GadgetReboot/AY-3-8910/README.md

# AY-3-8910
AY-3-8910 Sound Generator PCB controlled by Arduino Nano<BR><BR>
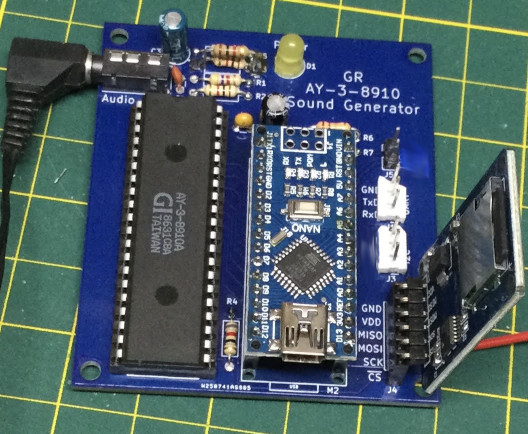
[picture p1: Assembled_PCB.jpg]
pcb
<br><br>
