GadgetReboot/AY-3-8910/AY-3-8910-sch.pdf

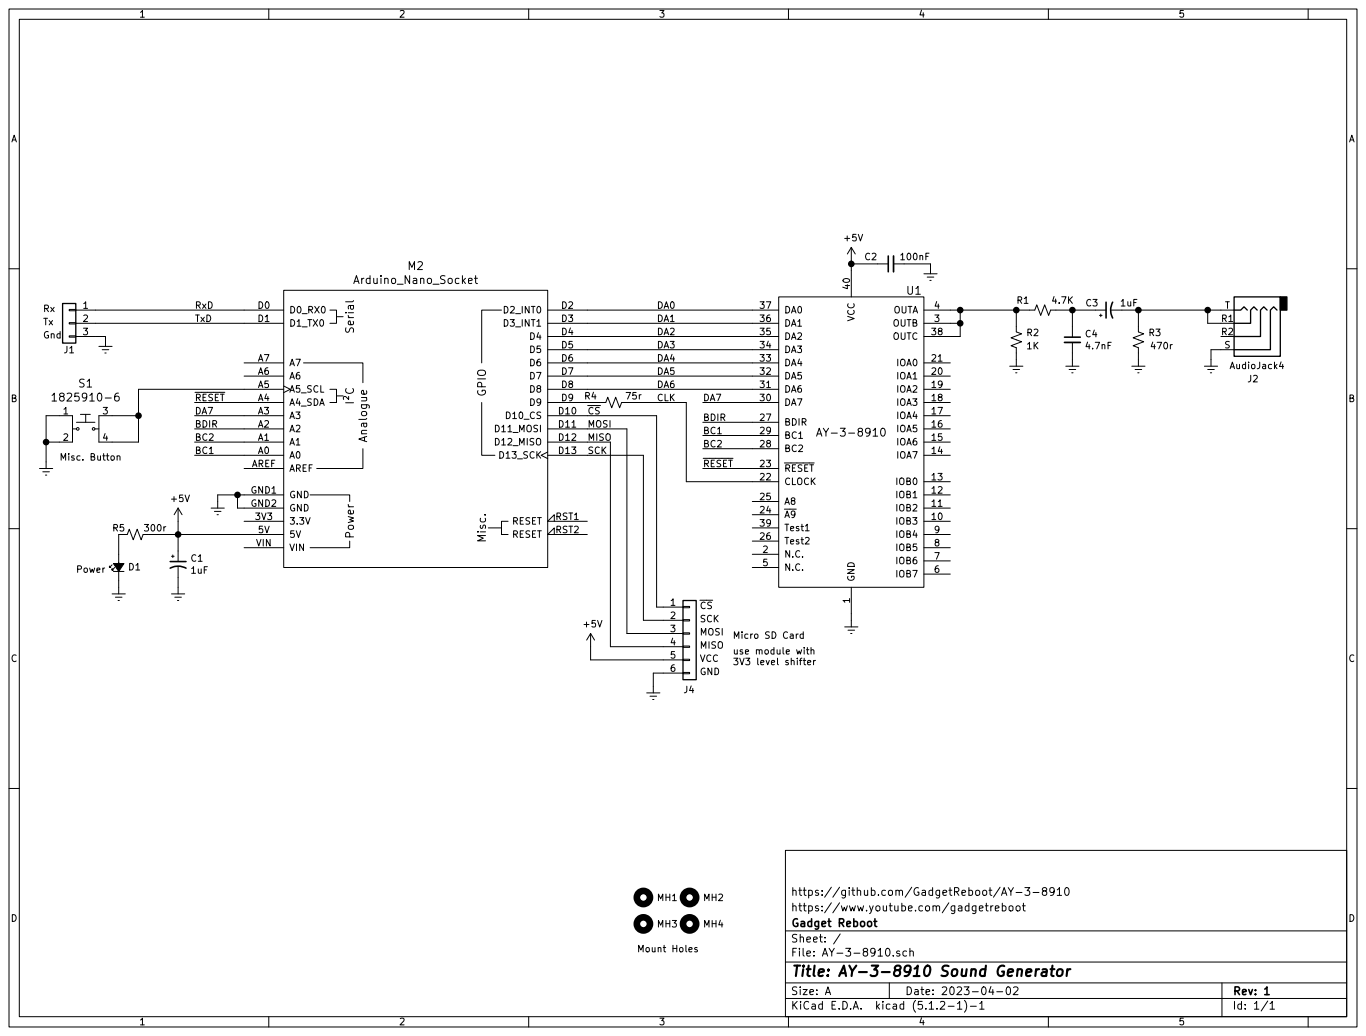
[picture p2: page 1]

https://www.youtube.com/gadgetreboot
Id: 1/1 Title: AY-3-8910 Sound Generator File: AY-3-8910.sch Sheet: / Gadget Reboot
