GadgetReboot/AY-3-8910/KiCad/AY-3-8910.kicad_pcb

## KiCad design KiCad/AY-3-8910.kicad_pcb (2023-04-19)

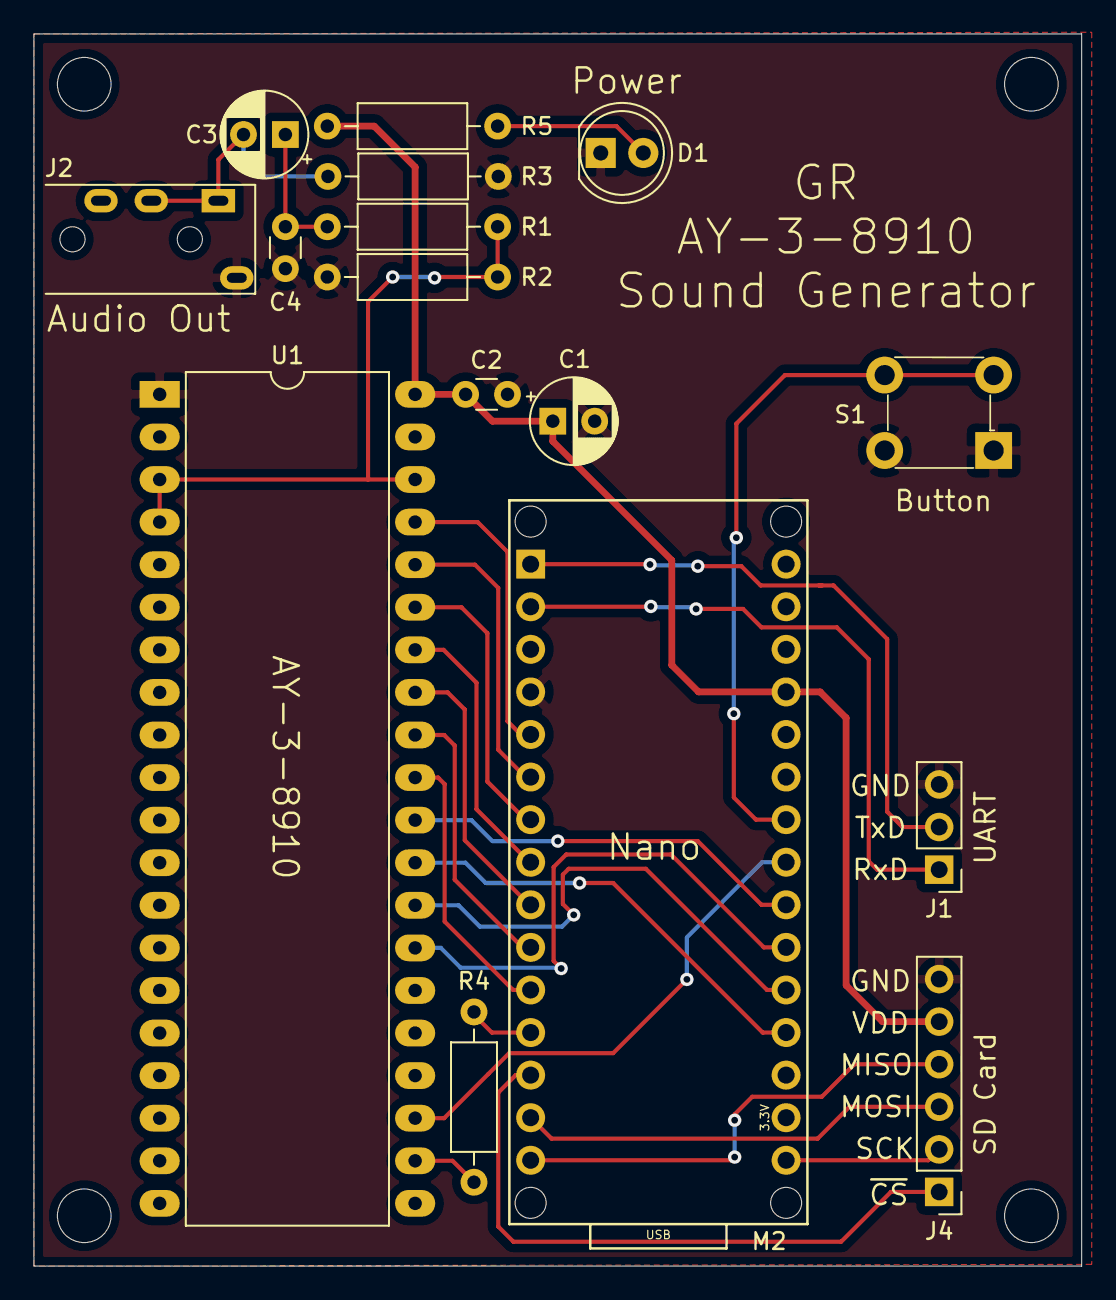
[picture p3: board AY-3-8910.kicad_pcb from above]

Board: 2 copper layers, 62.5 x 73.5 mm, 20 parts (0 on the bottom side), 27 nets.

Parts:
C1, C3: 1uF; CP_Radial_D5.0mm_P2.50mm
C2: 100nF; C_Disc_D3.0mm_W1.6mm_P2.50mm
C4: 4.7nF; C_Disc_D3.0mm_W1.6mm_P2.50mm
D1: LED_Small_ALT; LED_D5.0mm
J1: UART; PinHeader_1x03_P2.54mm_Vertical
J2: AudioJack4; Jack_3.5mm_PJ320A_Horizontal
J4: Conn_01x06; PinHeader_1x06_P2.54mm_Vertical
M2: Arduino_Nano_Socket
MH1, MH2, MH3, MH4: MountingHole; MountingHole_3.2mm_M3
R1: 4.7K; R_Axial_DIN0207_L6.3mm_D2.5mm_P10.16mm_Horizontal
R2: 1K; R_Axial_DIN0207_L6.3mm_D2.5mm_P10.16mm_Horizontal
R3: 470r; R_Axial_DIN0207_L6.3mm_D2.5mm_P10.16mm_Horizontal
R4: 75r; R_Axial_DIN0207_L6.3mm_D2.5mm_P10.16mm_Horizontal
R5: 300r; R_Axial_DIN0207_L6.3mm_D2.5mm_P10.16mm_Horizontal
S1: 1825910-6; Switch_Tactile_THT_6x6mm
U1: AY-3-8910; DIP-40_W15.24mm_LongPads

Connections:
+5V: C1.1, C2.1, J4.5, M2.5V, R5.1, U1.40
/BC1: M2.A0, U1.29
/BC2: M2.A1, U1.28
/BDIR: M2.A2, U1.27
/CLK: R4.1, U1.22
/DA0: M2.D2, U1.37
/DA1: M2.D3, U1.36
/DA2: M2.D4, U1.35
/DA3: M2.D5, U1.34
/DA4: M2.D6, U1.33
/DA5: M2.D7, U1.32
/DA6: M2.D8, U1.31
/DA7: M2.A3, U1.30
/MISO: J4.4, M2.D12
/MOSI: J4.3, M2.D11
/RxD: J1.1, M2.D0
/SCK: J4.2, M2.D13
/TxD: J1.2, M2.D1
/~CS: J4.1, M2.D10
/~RESET: M2.A4, U1.23
GNDREF: C1.2, C2.2, C4.2, D1.1, J1.3, J2.S, J4.6, M2.GND1, M2.GND2, R2.1, R3.1, S1.1, S1.2, U1.1
unnamed: C3.1, C4.1, R1.1
unnamed: C3.2, J2.R1, J2.T, R3.2
unnamed: D1.2, R5.2
unnamed: M2.A5, S1.3, S1.4
unnamed: M2.D9, R4.2
unnamed: R1.2, R2.2, U1.3, U1.4, U1.38
